mattsb42/screwfinity-openscad/examples/index.md

This directory contains several examples of
things that you can do with Screwfinity Rebuilt,
and how to do it.
