mattsb42/screwfinity-openscad/constants.scad

// Standard gridfinity grid size.
GRIDFINITY_GRID_LENGTH = 42;

// Thickness of cabinet read wall.
CABINET_REAR_WALL = 2;

// Depth of drawer stop at front of slot.
DRAWER_STOP = 2;

// Gap between drawer and walls.
DRAWER_TOLERANCE = 0.5;

// Difference between grid_u and drawer_u slot interior width.
GU_TO_DU = 3;

// Chamfer height to smooth out sharp edges.
CHAMFER_HEIGHT = 0.5;
