mattsb42/screwfinity-openscad/options.scad

// Standard sizes
SMALL = 20;
MEDIUM = 30;
LARGE = 40;

// Drawer fill options
NO_CUT = 0;
SCOOP_CUT = 1;
SQUARE_CUT = 2;

// Drawer label options
NO_LABEL_CUT = 0;
LABEL_CUT = 1;

// Drawer handle options
TRIANGLE_HANDLE = 1;

// Cabinet base options
NO_BASE = 0;
GRIDFINITY_BASE = 1;

// Cabinet top options
NO_TOP = 0;
LIP_TOP = 1;
GRIDFINITY_STACKING_TOP = 2;
GRIDFINITY_BASEPLATE_MAGNET_TOP = 3;
