mattsb42/screwfinity-openscad/tests/vectors/drawer.scad

include <../../options.scad>;
use <../../drawer.scad>;
$fa = 1;
$fs = 0.4;

unit_width = 1;
unit_depth = 1;
height = 10;
wall_thickness = 1;
fill_type = SQUARE_CUT;
label_cut = NO_LABEL_CUT;
handle_style = TRIANGLE_HANDLE;
handle_depth = 8;


Drawer(
    dimensions=drawer_options(
        unit_width=unit_width,
        unit_depth=unit_depth,
        height=height
    ),
    drawer_wall=wall_thickness,
    fill_type=fill_type,
    label_cut=label_cut,
    handle_options=[handle_style, handle_depth]
);
