mattsb42/screwfinity-openscad/(list of files, cad)

Other CAD files:
tests/vectors/cabinet-complex.scad
tests/vectors/screwfinity-cabinet.scad
tests/vectors/screwfinity-drawer.scad
