mattsb42/screwfinity-openscad/(commit log)

2024-08-14 feat: parametric screwfinity drawer
    [drawer.scad]
2024-08-14 fix: drawer depth
    [cabinet.scad, drawer.scad]
2024-08-14 chore: move constants into constants
    [cabinet.scad, constants.scad, drawer.scad]
2024-08-14 fix: move base of handle to bottom of drawer
    [drawer.scad]
2024-08-14 fix: adjust drawer upper lip to correct thickness to accomodate label cutout
    [drawer.scad]
2024-08-14 feat: add drawer slot and stop
    [cabinet.scad]
2024-08-14 chore: remove unnecessary configs
    [drawer.scad]
2024-08-15 chore: remove unused constants
    [constants.scad]
2024-08-15 feat: populate cabinets and fix horizontal slot scaling
    [cabinet.scad]
2024-08-15 fix: fix 1U-wide boundary error and add input validation
    [cabinet.scad]
2024-08-15 chore: add input validation for drawer u_depth
    [drawer.scad]
2024-08-15 feat: convert to negative space construction for cabinets
    [cabinet.scad]
2024-08-15 fix: correct drawer width
    [constants.scad]
2024-08-15 chore: simplify drawer handle layout
    [drawer.scad]
2024-08-16 feat: add option for solid drawer fill
    [constants.scad, drawer.scad, options.scad]
2024-08-16 feat: add scoop cutout for drawers
    [drawer.scad]
2024-08-16 fix: correct drawer slot horizontal spacing and drawer width calculation
    [cabinet.scad, constants.scad, drawer.scad]
2024-08-17 chore: convert drawer to xyz
    [drawer.scad]
2024-08-17 chore: convert cabinet to xyz
    [cabinet.scad]
2024-08-17 fix: naming for no cut option
    [drawer.scad, options.scad]
2024-08-17 feat: add gridfinity base option, fixes #7
    [cabinet.scad, options.scad]
2024-08-17 feat: add chamfer to drawer base, fixes #10
    [constants.scad, drawer.scad, util.scad]
2024-08-17 feat: make lip adjustable and add option for cabinet lip top, fixes #8
    [cabinet.scad, drawer.scad, options.scad, util.scad]
2024-08-17 fix: correct the center adjust for Lip
    [util.scad]
2024-08-17 fix: add a small buffer around the lip top. just the lip itself is too thin at the peak
    [cabinet.scad]
2024-08-17 feat: add gridfinity stacking lip tops #9
    [cabinet.scad, options.scad]
2024-08-18 feat: add variable-row cabinet building
    [cabinet.scad]
2024-08-18 feat: enable diverse rows, fixes #6
    [cabinet.scad, util.scad]
2024-08-18 fix: remove deprecated parameter and move input check to inspect grid
    [cabinet.scad]
2024-08-18 feat: unlock inefficient columns to fix #5
    [cabinet.scad]
2024-08-18 chore: reorganize repo to make importing from this repo via submodule cleaner
    [cabinet.scad, constants.scad, drawer.scad, options.scad, util.scad]
2024-08-18 feat: convert Drawer to xyz
    [drawer.scad]
2024-08-18 fix: fix incorrect references and normalize base/top config
    [cabinet.scad]
2024-08-18 feat: add gridfinity magnet baseplate top option, fixes #9
    [cabinet.scad, options.scad]
2024-08-18 chore: standardize default hole options and add crush ribs
    [cabinet.scad]
2024-08-18 chore: flesh out input validation on Drawer #22
    [drawer.scad]
2024-08-18 fix: slice off protrusions beyond drawer walls, fixes #20
    [drawer.scad]
2024-08-18 fix: incorrect variable reference
    [drawer.scad]
2024-08-31 feat: add initial test harness
    [drawer.scad]
2024-09-01 fix: pin latest Actions versions
2024-09-01 chore: add grid-expand tests
    [cabinet-grid-expand.scad]
2024-09-01 chore: add complex cabinet tests
    [cabinet-complex.scad]
2024-09-01 chore: set camera angle for cabinet tests
2024-09-01 chore: add compatibility vectors
    [screwfinity-cabinet.scad]
2024-09-02 feat: add drawer label cutouts
    [drawer.scad, options.scad]
2024-09-02 chore: tune offsets
    [drawer.scad]
2024-09-02 fix: cleanup code and fix angles
    [drawer.scad]
2024-09-02 chore: screwfinity-compatibility artifacts should use label cuts
    [screwfinity-cabinet.scad]
2024-09-02 fix: add label cut to drawer test file
    [drawer.scad]
2024-09-02 docs: update docs to cover label slots
2024-09-03 feat: add screwfinity upstream drawer outputs
    [screwfinity-cabinet.scad, screwfinity-drawer.scad]
2024-09-03 feat: add labels
    [drawer.scad, util.scad]
2024-09-04 docs: update screwfinity upstream examples to include label cuts
2024-09-25 feat: add adjustable drawer handle depth, fixes #24
    [drawer-handles.scad, drawer.scad, options.scad]
