mattsb42/screwfinity-openscad/(notices)

Notices in the files:
README.md:
License: MIT
